Srini0047/ASIC-Implementation-of-Systolic-Array-based-DNN-accelerator/docs/presentation/img/lrb_fill_replay.png

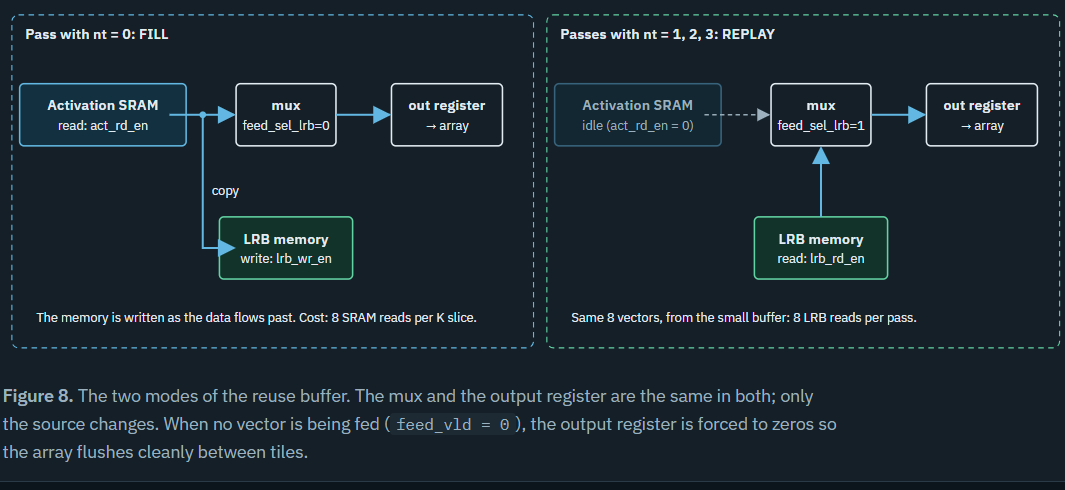
docs/presentation/img/lrb_fill_replay.png
