Srini0047/ASIC-Implementation-of-Systolic-Array-based-DNN-accelerator/docs/presentation/img/syn_top_schematic.png

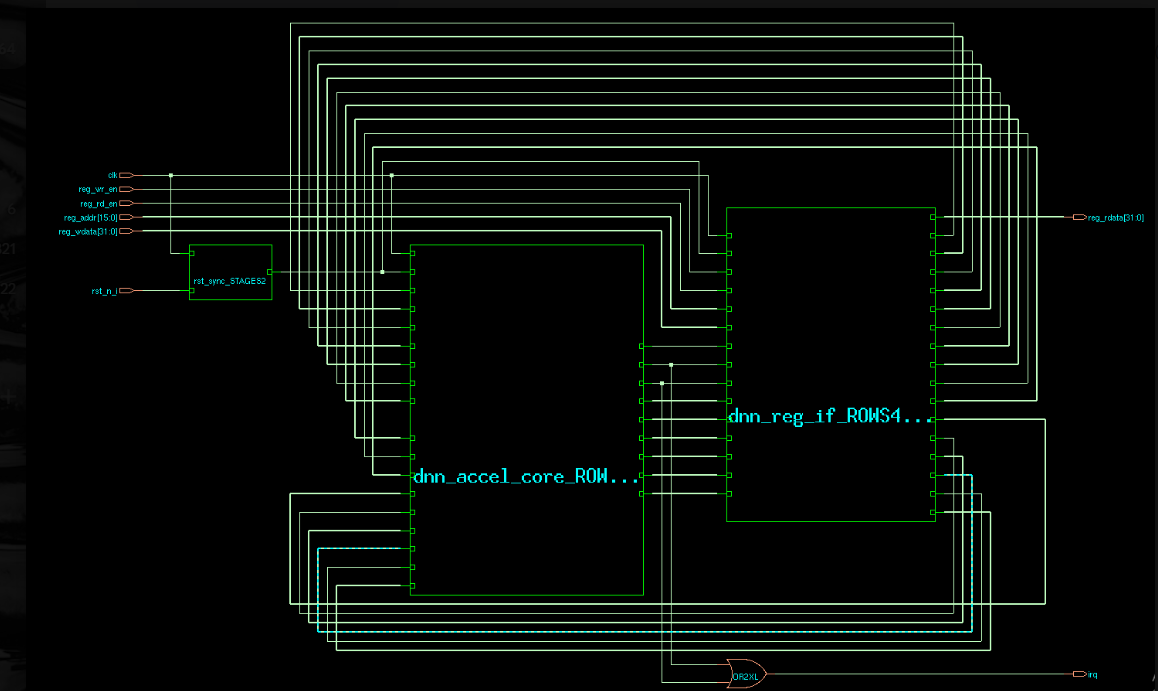
docs/presentation/img/syn_top_schematic.png
