Srini0047/ASIC-Implementation-of-Systolic-Array-based-DNN-accelerator/build/digits_preview.html

# The pictures in this project

Each picture is 8 x 8 = 64 pixels. Black = ink (value 1.0), white = paper (0.0). The number under each is the correct answer (the label).

## 1. The 360 test pictures, one batch of 8 per row

Row "batch k" is what the testbench feeds to the chip in batch k. The chip has never seen these during training.

batch 0

#0: 7

#1: 6

#2: 3

#3: 7

#4: 7

#5: 3

#6: 2

#7: 8

batch 1

#8: 9

#9: 3

#10: 2

#11: 6

#12: 6

#13: 4

#14: 5

#15: 8

batch 2

#16: 1

#17: 3

#18: 5

#19: 6

#20: 3

#21: 8

#22: 7

#23: 3

batch 3

#24: 0

#25: 2

#26: 8

#27: 4

#28: 5

#29: 8

#30: 6

#31: 7

batch 4

#32: 0

#33: 1

#34: 2

#35: 2

#36: 2

#37: 7

#38: 0

#39: 5

batch 5

#40: 9

#41: 9

#42: 0

#43: 9

#44: 1

#45: 1

#46: 3

#47: 5

batch 6

#48: 9

#49: 7

#50: 8

#51: 3

#52: 4

#53: 3

#54: 0

#55: 3

batch 7

#56: 4

#57: 2

#58: 6

#59: 0

#60: 4

#61: 8

#62: 9

#63: 1

batch 8

#64: 9

#65: 6

#66: 7

#67: 3

#68: 4

#69: 9

#70: 0

#71: 6

batch 9

#72: 2

#73: 8

#74: 8

#75: 3

#76: 8

#77: 9

#78: 7

#79: 9

batch 10

#80: 2

#81: 6

#82: 3

#83: 4

#84: 0

#85: 8

#86: 7

#87: 3

batch 11

#88: 5

#89: 0

#90: 1

#91: 4

#92: 9

#93: 6

#94: 3

#95: 4

batch 12

#96: 5

#97: 9

#98: 2

#99: 6

#100: 5

#101: 2

#102: 1

#103: 5

batch 13

#104: 9

#105: 1

#106: 1

#107: 1

#108: 9

#109: 7

#110: 6

#111: 9

batch 14

#112: 5

#113: 5

#114: 0

#115: 5

#116: 2

#117: 4

#118: 0

#119: 2

batch 15

#120: 7

#121: 2

#122: 8

#123: 1

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

INT8 in the chip

0 | 0 | 16 | 103 | 127 | 71 | 0 | 0
0 | 0 | 95 | 95 | 56 | 127 | 24 | 0
0 | 8 | 111 | 24 | 0 | 127 | 32 | 0
0 | 0 | 0 | 32 | 79 | 127 | 48 | 0
0 | 0 | 0 | 103 | 127 | 127 | 71 | 0
0 | 0 | 0 | 40 | 103 | 8 | 0 | 0
0 | 0 | 0 | 87 | 71 | 0 | 0 | 0
0 | 0 | 8 | 127 | 32 | 0 | 0 | 0
