Srini0047/ASIC-Implementation-of-Systolic-Array-based-DNN-accelerator/docs/BEGINNER_GUIDE.html

# Accelerator Beginner Guide

What the project files are, why each one exists, and exactly what to type. Written for someone who can simulate Verilog in Xcelium but has never seen the Python, C or script parts.

Everything in this guide was checked on the real files, with one limit: I do not have Xcelium, ModelSim, Genus or Innovus here. The simulation was tested on another 4-state simulator (Icarus) with identical results; the commands for your tools are written carefully but were not run on them. Section 11 says what to do if one fails.

## 0. Start here: your job list

The project is one chip design (Verilog) plus a small amount of helper material around it. You do not need to understand or run all of it. Your work is a setup step (Job 0) followed by five jobs, in this order. Job 1 needs only the simulator you already have.

Job 1: run the simulationXcelium or ModelSim runs the chip on 360 handwritten-digit images and prints PASSED.

about 20 minutes · section 6

Job 2: look at the waveformOpen the signals, take 3–4 screenshots for your report.

about 30 minutes · section 7

Job 3: the Python sideRebuild the chip's input, print the accuracy report. Optional, but it is what makes this a neural-network project.

about 30 minutes · section 8

Job 4: synthesisGenus turns the design into gates and reports area, speed and power.

1–3 hours, depends on your lab setup · section 9

Job 5: the reportFill in the numbers table and write it up.

section 10

You do this

If you only have one hour: do Job 1. It proves the design works and it needs no Python at all, because the input file the chip reads (build/prog.hex) is already inside the zip.

You can ignore

Verilator (I used it, you do not need it), the C driver (explained in section 3, you never run it), PyTorch training (already done, result is shipped), and every file ending in .sh in the scripts folder (they call Verilator; your replacements are in the cadence folder).

## 1. The story in plain words

The chip recognises handwritten digits. You give it a tiny 8×8 grey picture (64 numbers), it does a fixed amount of arithmetic, and it answers with ten scores, one per digit 0–9. The biggest score is its guess.

Analogy. Think of the chip as a vending machine that has ten judges inside. Each judge looks at the 64 pixels and gives a score for "how much does this look like my digit". The judges' preferences are a big table of numbers called weights. Somebody has to teach the judges (training), write their preferences down in whole numbers the machine can handle (quantization), and press the machine's keypad once for every number (loading). The machine itself never does any of that: it only does the arithmetic.

That "somebody" is the reason there is a Python folder, a C folder and a build folder. Figure 1 shows the whole chain. Blue boxes are Python on your PC. Green boxes are Verilog running inside the simulator.

Figure 1. Python prepares a text file of keypad presses; the testbench plays the role of the CPU and presses them into the chip; the chip's answers are written to a file that report.py turns into an accuracy number.

The file prog.hex is the link between the two halves. It is plain text, 9 677 lines: 9 676 keypad presses, one per line, plus a final END marker. Here is the beginning of it, decoded:

Line in prog.hex | Split into | Meaning
03000004d44a0100 | 03 · 00 · 0004 · d44a0100 | Operation 03 = "read and check". Read register number 4 (the chip's ID) and complain unless it equals d44a0100. It proves the testbench is talking to the right chip.
01001000fbfd0400 | 01 · 00 · 1000 · fbfd0400 | Operation 01 = "write". Put the value fbfd0400 at address 1000, which is the start of the weight memory. That value packs four weights (0, 4, −3, −5) into 32 bits.

The remaining lines load all 304 rows of weights, the biases, a description of each layer, then the pictures, then press START, wait, and read the answers back. The chip's own registers and memories are all reached the same way: an address and a number.

## 2. Basics from zero

### 2.1 What "the neural network" is here

It is two layers of multiplication and addition. Nothing else. For one picture:

Step | What happens | Shape of the numbers
Input | the 8×8 picture, flattened into one row of 64 numbers | x : [1 × 64]
Layer 1 | 16 "neurons". Each one multiplies all 64 pixels by its own 64 weights and adds them up, then adds a bias number. Negative results become 0 (this is called ReLU). | x [1×64] · W1 [64×16] + b1 [16] → h [1×16]
Layer 2 | 10 neurons, one per digit, each looking at the 16 numbers from layer 1 | h [1×16] · W2 [16×10] + b2 [10] → scores [1×10]
Answer | the position of the biggest score | argmax → one digit

A real example from this project (picture number 0, which is a handwritten 7): neuron 5 of layer 1 multiplies 64 pixel values by 64 weights and adds them up to 29 657, adds its bias 4 550 to get 34 207, and rescales that to 45. Layer 2 then gives the ten scores [−8, −14, −24, −10, −3, −27, −34, 34, −4, 20]. The biggest is 34 at position 7. The chip says "7". You can see every such number yourself with python sw\trace_one.py 0 5 (section 8).

The weights are the only thing that was "learned". Training (with a library called PyTorch) tried thousands of values until the guesses on known pictures were right. That already happened; the result is in build/model.onnx.

### 2.2 What "MAC" means, and why it is the whole game

A MAC is one multiply followed by one add: total = total + weight × pixel. Layer 1 needs 64 × 16 = 1 024 of them, layer 2 needs 16 × 10 = 160, so 1 184 MACs per picture. A neural-network chip is a machine for doing MACs cheaply. Doing them is easy; the expensive part is fetching the weights and pixels from memory, so the design is built to fetch each number as few times as possible.

### 2.3 What "systolic array" means

Analogy. A bucket brigade. Instead of every worker walking to the warehouse, each worker hands the item to the next person in the line. Here the "workers" are 16 small multiply-add circuits (PEs, processing elements) in a 4×4 grid. Each PE keeps one weight for a while, pixels flow across the grid from the left, and running totals flow down. Nobody talks to the big memory except at the edges.

Figure 2. The 4×4 array in rtl/pe.v and rtl/systolic_array.v. Four pixels enter on the left, staggered by one clock per row; each box multiplies its stored weight by the pixel passing through and adds it to the total arriving from above. Four sums leave at the bottom, which is 4 neurons answered at once.

A 4×4 array only sees 4 pixels and 4 neurons at a time, but the network has 64 pixels and 16 neurons. So the controller (rtl/dnn_ctrl.v) cuts the work into tiles: layer 1 becomes 16 × 4 = 64 tile-runs ("passes"), layer 2 another 12. In each pass it loads 4×4 = 16 weights (4 clocks), streams the 8 pictures of a batch through (8 clocks), and waits for the pipeline to empty (about 11 clocks). Partial totals from different tiles are added in a small memory. Everything in this paragraph is done by RTL you already have; you only need to know why the waveform looks the way it does.

### 2.4 Why 8-bit integers ("INT8")

Trained weights are decimals such as 0.0168. Decimal (floating-point) maths costs roughly ten times or more energy than 8-bit integer maths, so before the chip sees them each number is converted: pick a scale (0.01685 for layer 1), divide, round to a whole number between −127 and 127. This step is quantization and lives in sw/quantize.py. The price is a tiny accuracy loss; here there is none: the decimal network scores 96.94 % on 360 unseen pictures, and so does the integer network, and so does the chip.

The chip's integer sums are large (like 34 207), so the last stage shrinks them back to 8 bits with a "multiply by 44203, then shift right by 25 bits" step. That equals multiplying by 0.001317 without needing a decimal multiplier.

### 2.5 Why the chip cannot run by itself

The chip has memories that start empty and registers that start at zero. To use it, something must (1) write 304 rows of weights into the weight memory, (2) write the biases and a "work order" for each layer, (3) write the picture into the input memory, (4) write 1 to the START register, (5) wait until DONE, (6) read the answers back. In a real product a small CPU does this by running driver software. In your simulation the testbench does it by replaying prog.hex. Same steps, different actor. Section 3 shows this side by side (Figure 3).

## 3. What every folder is for

Open the unzipped folder systolic_dnn_accel. Inside are these folders. The coloured tag says what you need to do with each one.

- systolic_dnn_accel/
  - rtl/ your chipThe Verilog design: 17 files, of which 15 make up the DNN accelerator (the other two belong to the older matrix-multiply version). This is the actual accelerator.
  - tb/ use one filetb_dnn_player.v is the testbench. The other three are for the older first version.
  - cadence/ your launch filesNew. Ready-made commands for Xcelium, ModelSim, Genus, plus double-click Python helpers for Windows.
  - build/ inputs and outputsNumbers going into the chip and answers coming out. Pre-filled, so you can simulate straight away.
  - sw/ optional"Software": Python programs that prepare the chip's input and check its output.
  - driver/ read onlyC code a real processor would run. You never run it.
  - scripts/ ignoreMy own test runners; they need Verilator, which you do not have.
  - docs/ readingThe technical documents from before, plus this guide.
  - README.md, requirements.txt ignoreShort notes for people with the full open-source toolchain.

### 3.1 rtl/ and tb/: what you already understand

RTL is the chip: registers and logic written in Verilog. The files you would use if you were building the chip are all in rtl/. The top-level module is dnn_accel_top (or dnn_accel_axil_top, the same chip with an AXI bus plug on the front). Files starting with accel_ctrl or systolic_accel_top belong to the first, simpler version and are not part of the DNN design.

A testbench is Verilog that is not the chip; it exists only to poke the chip in simulation. tb/tb_dnn_player.v is a "player": it reads a program file (prog.hex), and for each line writes or reads one chip register, exactly as a CPU would. It counts mismatches and prints PLAYER PASSED or PLAYER FAILED.

### 3.2 sw/: why there is Python at all

The chip only understands integers and register writes. Someone has to turn "a trained neural network" into those. That someone is a short series of Python programs, each doing one job, all readable in a text editor:

File | What it does, in plain words | Needs | Run it?
train_mlp.py | Teaches the network to recognise digits, using the 1 797 example pictures that ship inside a library called scikit-learn. Saves build/model.onnx (the learned numbers). | PyTorch, scikit-learn, onnx (a very large download) | already done
quantize.py | Converts the learned decimals into whole numbers the chip can use, and finds the "multiply then shift" numbers. Prints float accuracy and integer accuracy. | numpy, onnx, onnxruntime | Job 3
golden.py | The "answer key": does the same integer arithmetic as the chip, but in Python, so the chip's answers can be checked bit for bit. | numpy | used by others
compiler_lib.py, compile.py | The "compiler": cuts the network into 4×4 tiles, decides which memory address each number goes to, and writes build/prog.hex (the keypad presses). Also writes net_image.h for the C driver. | numpy | Job 3
dnn_cfg.py | One list of chip settings (array size 4, memory depths) that must match the Verilog parameters. | nothing | used by others
report.py | Reads the chip's answers from build/rtl_readback.txt, computes accuracy from the chip's numbers, prints speed figures. | numpy | Job 3
trace_one.py | Follows one picture through the network and prints every number. This is the best "what is happening" teaching tool. | numpy | Job 3
example_tiny_net.py, show_tiny.py | A 4-number example small enough to check with a pencil, and a decoder for the chip's answer. | numpy (show_tiny.py needs nothing but Python) | Job 3
gen_random_net.py | Makes random networks and deliberately illegal commands for stress tests. | numpy | ignore
sweep_arch.py | Tries array sizes 4, 8 and 16 with Verilator to compare speed. Its table is already copied into docs/02. | Verilator | ignore

### 3.3 build/: what that folder is

"Build" folders hold generated files: things produced by running a program, as opposed to things a person wrote. If you delete something in build/ you can produce it again; if you delete something in rtl/ it is gone. I left the finished results in it so that your first simulation needs no Python.

File | What it is | Made by
model.onnx | The trained network (weights as decimals). ONNX is a standard file format for networks, like PDF is for documents. | train_mlp.py
data.npz | The 360 test pictures and their true labels. | train_mlp.py
qnet.npz | The same network after conversion to integers. | quantize.py
prog.hex | The main chip input. 9 676 keypad presses plus an END line (9 677 lines): load weights, run 45 batches of 8 pictures, read back answers. | compile.py
prog_meta.json | A label for each "read" in prog.hex, so report.py knows which answer is which. | compile.py
wave_prog.hex | The first 568 lines of prog.hex plus an END line: one batch only, so waveform files stay small. | cut from prog.hex
tiny_prog.hex | Program for the 4-number pencil example. | example_tiny_net.py
net_image.h | The network written as C arrays, for the C driver. | compile.py
rtl_readback.txt | The main chip output: every value the chip returned, one per line. Written by the simulator, read by report.py. | simulation
c_trace.hex, c_prog.hex, py_trace_first.hex, c_rtl_readback.txt, axil_readback.txt, tiny_readback.txt | Leftovers from my own tests (driver check, AXI check). Ignore them. | my scripts

### 3.4 driver/: what a "driver" is, and why you never run it

A driver is the program on the processor that knows how to talk to a piece of hardware. Your keyboard, GPU and Wi-Fi card all have one. For this chip, the driver is about 250 lines of C: dnn_load_network() writes weights and layer descriptions, dnn_write_input() writes a picture, dnn_run() presses START and waits, dnn_read_output() reads the ten scores.

It exists for two reasons. First, a chip without software is unusable, so a complete project shows how software would use it. Second, it is an independent check: I made the C driver produce its own list of register writes and compared it with the Python compiler's list. They match on all 568 accesses of the first batch, which means the register map documented in docs/05 is really what the chip does, and not just what one program believes. That is the whole reason for it. The C code is not needed for your simulation, and you cannot run it on your PC in any useful way because there is no chip attached.

Figure 3. The chip is identical in both worlds. Only the actor changes. The Python compiler and the C driver are two independent ways of producing the same register writes, which is why the driver appears in this project at all.

### 3.5 scripts/: what a script is

A script is a text file containing commands you would otherwise type one by one. A .sh file is a script for a Linux shell; a .bat file is the Windows equivalent. Running a script just means "type all the commands in that file for me". Nothing magic.

The scripts in scripts/ are mine. They build the chip with Verilator (a free simulator), run it, and compare results. You do not have Verilator, so you use the equivalents in cadence/, which call Xcelium or ModelSim instead:

My script (needs Verilator) | What it does | Your replacement
scripts/run_all.sh | Runs the whole chain: Python steps, simulation, report, driver check, AXI check. | Job 1 + Job 3, done by hand in sections 6 and 8
scripts/run_tiny.sh | The 4-number example. | cadence\run_modelsim.bat tiny or --prog build/tiny_prog.hex
scripts/run_wave.sh | Simulation that also saves a waveform file. | run_xcelium.sh --wave / run_modelsim.bat gui
scripts/check_driver.sh | Compares the C driver's writes with the Python compiler's. | none needed
scripts/run_dnn_regress.sh, run_regress.sh, run_mutations.sh | Big test campaigns: 240 random networks, 19 deliberately broken copies of the design. | none needed; results are quoted in docs/06
scripts/check_rtl_quality.sh, check_psum_formula.sh | Lint and structure checks; a formula check. | none needed (Genus and Xcelium do their own checks)

Why this matters

If someone asks in your presentation "how do you know the design is correct", the honest answer is: the chip returns exactly the same numbers as an independent integer model, on 360 pictures and on 240 random networks, and 19 deliberately introduced bugs were all caught by those tests. These are the scripts that did it. You only need to reproduce the first part (Job 1).

## 4. Words you will meet

Word | Plain meaning
Terminal / command prompt / cmd | A window where you type a command and press Enter. On Windows it is called Command Prompt (cmd); on Linux it is the terminal.
Current folder ("working directory") | The folder the terminal is "standing in". Commands with a relative path like build/prog.hex look inside it. Almost every problem with these files comes from being in the wrong folder. You want to be in systolic_dnn_accel.
cd | "Change directory": walk the terminal into another folder. cd systolic_dnn_accel steps into it.
pip | Python's installer for add-on libraries. pip install numpy downloads numpy.
numpy, onnx, onnxruntime | Python libraries: number arrays, the network file format, and a program that runs a network from that format.
Hex file | A text file of numbers written in base 16 (0–9 then a–f). fb = 251 = a single byte.
Register | A numbered mailbox inside the chip. Writing a number to it changes chip behaviour; reading it tells you something.
Batch | Several pictures processed together (8 here) so that each weight loaded is used 8 times.
INT8 / bias / ReLU | Whole numbers from −128 to 127 / a fixed number added to each neuron's sum / "turn negative into 0".
Plusarg (+prog=...) | A setting typed after the simulator command, starting with +. It tells the testbench which program file to read.
Waveform | A picture of signals against time, like a heart monitor for the chip.
Synthesis, netlist | Turning Verilog into a list of real logic gates from a manufacturer's library. That list is the netlist.
SDC | A short file telling the synthesis tool the speed you want (the clock) and what surrounds the chip.
Slack | Spare time on the slowest path. Positive is good (fast enough); negative means the clock is too fast for the gates.

## 5. Job 0: set up your files

You have two possible setups. Find out which you have before continuing, because the commands differ.

| Setup A: everything on your Windows PC | Setup B: Cadence tools on a Linux server or lab machine
How you know | You can start ModelSim from the Windows Start menu, and Python works in the same cmd window. | You log in remotely (a terminal, or a remote desktop) to a Linux machine to use Xcelium, Genus, Innovus.
Simulator | ModelSim, using cadence\run_modelsim.bat | Xcelium, using bash cadence/run_xcelium.sh
Python | same PC, cmd | either on your PC (recommended), or the server's Python 3 if it has numpy
Genus / Innovus | not available here, go to the Linux machine for Job 4 | the same Linux machine

Setup B and Python: two kinds of file travel

In Setup B the simulator runs on the server but your Python (Job 3) is on your PC, so the files they produce must be moved by hand (WinSCP, step 5 below, works both ways):

- Made by Python on the PC, needed by the simulator: build/prog.hex and build/tiny_prog.hex. Only when you regenerate them; the shipped copies already work.
- Made by the simulator on the server, needed by Python: build/rtl_readback.txt (for the report) and build/custom_readback.txt (for the pencil example). Copy them into the same build folder on the PC.

The shortcut that avoids all copying: run the Python steps on the server as well, with python3 instead of python and forward slashes (Job 3 shows both forms). That needs numpy on the server: test it with python3 -c "import numpy"; no output means it is there.

Most university Cadence installs are Setup B. The instructions below cover both. If you are unsure, do steps 1 to 4 (they are needed in both), and ask your lab assistant how to open a terminal on the Cadence machine.

1. Put the zip somewhere with a short path.
  In File Explorer, find systolic_dnn_accel_v2.zip. Right-click it, choose Extract All…, and in the box that asks where, replace the suggested path with C:\projects (click Browse and create the folder if it does not exist), then click Extract. Avoid folders with spaces in their names such as "My Documents". You now have C:\projects\systolic_dnn_accel.
2. Open a command window standing in that folder.
  In File Explorer open C:\projects\systolic_dnn_accel. Click once in the address bar at the top (where the path is written), type cmd, press Enter. A black window opens whose first line ends with systolic_dnn_accel>. That is the "current folder" from section 4.
3. Check that you are in the right place.
  Type in: Windows cmdCopy

dir
  The listing must include rtl, tb, sw, build, cadence. If it does not, you are one folder too high or too low: use cd to move.
4. Check Python.
  Type in: Windows cmdCopy

python --version
  You should see Python 3.13.3. If Windows says "python is not recognized", try py --version; if that works, use py instead of python everywhere in this guide, and write py -m pip install ... wherever the guide says python -m pip install ....
5. Setup B only: copy the folder to the Linux machine and open a terminal there.
  Ask your lab how they move files (a shared network drive is common). If they have no preference, the free program WinSCP works: start it, in the login window choose File protocol: SFTP, type the server's Host name, your User name and password, click Login. The window shows your PC on the left and the server on the right. Drag the systolic_dnn_accel_v2.zip file from left to right. Then in the server's terminal:
  Type in: Linux terminalCopy

unzip systolic_dnn_accel_v2.zip
cd systolic_dnn_accel
ls
  If unzip is not installed, use python3 -m zipfile -e systolic_dnn_accel_v2.zip . instead. ls should list the same folders as above.
6. Setup B only: make the Cadence tools available.
  Cadence tools are usually not on the search path until you run a lab-specific setup line, something like source /opt/cadence/setup.csh or module load xcelium. Ask your lab assistant for "the line that loads Xcelium and Genus". Then check:
  Type in: Linux terminalCopy

which xrun
which genus
  Each must print a path. If it prints "no xrun in …", the setup line has not been run in this terminal window. (Each new terminal window needs it again unless your lab put it in your login file.)

## 6. Job 1: run the simulation

Goal: make the simulator run all 360 test pictures through your chip and print PASSED. What happens inside: the testbench reads build/prog.hex line by line, pushes each line into the chip as a register write or read, and compares every answer with the expected one that is already stored inside the file.

You do this

Make sure your terminal is standing in the systolic_dnn_accel folder (section 5, steps 2 and 3). Then follow Setup A or Setup B, not both.

### Setup A: ModelSim on Windows

1. Type the launch command.
  Type in: Windows cmd, inside systolic_dnn_accelCopy

cadence\run_modelsim.bat
  Or, in File Explorer, open the cadence folder and double-click run_modelsim.bat. It does the same and keeps its window open at the end. If Windows shows a blue "protected your PC" box, click More info, then Run anyway.
2. Wait. ModelSim first compiles the 16 Verilog files (the testbench plus the 15 design files; a few seconds), then simulates about 0.9 milliseconds of chip time. This takes from under a minute to a few minutes depending on the ModelSim edition.
3. Find the result near the bottom of the window.

If the .bat file does not work for any reason, this single command does the same thing (it needs vsim to be found too; if cmd says "vsim is not recognized", read the first row of the table in section 11):

Type in: Windows cmd, inside systolic_dnn_accelCopy

vsim -c -do cadence/run_modelsim.do

### Setup B: Xcelium on Linux

1. Type the launch command.
  Type in: Linux terminal, inside systolic_dnn_accelCopy

bash cadence/run_xcelium.sh
  (Use bash even if your terminal uses another shell; the file is written for bash.) The script checks that xrun exists, then runs it with the right file list and settings. It creates a few temporary files (xcelium.d, xrun.log) that you can delete later.
2. Wait a few minutes at most.
3. The last line of the output tells you the result.

### What a good result looks like

The simulator prints many of its own lines. Look for these two, which come from the testbench, and for the last line of the Xcelium script:

PLAYER: 9677 ops, 1313 reads, 0 mismatches, 0 timeouts, 79785 cycles polling
*** PLAYER PASSED ***
(Xcelium script only, last line:)
>>> RESULT: PASSED  (readback written to build/rtl_readback.txt)

What each number means:

Item | Meaning
9677 ops | The testbench executed all 9 677 lines of prog.hex (the last one is the END marker).
1313 reads | It read 1 313 values back from the chip. Of these, 1 088 were checked against the expected answer stored in the file: 8 ID/configuration registers plus 1 080 answer words (45 batches × 8 pictures × 3 words per picture). The other 225 are speed counters that are only logged.
0 mismatches | Every one of the 1 088 checks matched. This is the number that proves the chip is correct.
0 timeouts | The chip never got stuck waiting for itself.
79785 cycles polling | How long the testbench waited for the chip to finish, in clock cycles. It should be the same on your simulator; if it differs by a few cycles that is not a problem.

Harmless warnings

You will probably see a warning that $readmemh found fewer words than the memory it is filling (the memory has room for 262 144 lines and the file has 9 677). Some simulators also print a warning about missing timescales, or about unused parameters. If the two lines above appear, ignore the warnings.

If you see FAILED

Copy the first ten lines that contain FAIL or MISMATCH, plus the tool name and version, and send them to me. Section 11 lists the usual causes first.

### Optional second run: through the AXI bus

The same test, but the testbench talks to the chip through an AXI4-Lite bus plug (the standard way a processor connects to a peripheral), with random delays. It should also pass.

Type in: Windows cmd (Setup A)Copy

cadence\run_modelsim.bat axi

Type in: Linux terminal (Setup B)Copy

bash cadence/run_xcelium.sh --axi

Its answers go to build/axil_readback.txt, so the normal build/rtl_readback.txt from the first run stays untouched.

### The pencil example: see the chip do arithmetic you can check by hand

Before trusting 360 pictures, watch the chip do one tiny job. It takes two vectors of four numbers, multiplies them by a 4×4 weight table W = [1..16], adds a bias, and applies ReLU:

Step | Picture 0 | Picture 1
Input x [1×4] | [1 2 3 4] | [1 0 0 0]
x · W [1×4] 1·[1 2 3 4] + 2·[5 6 7 8] + 3·[9 10 11 12] + 4·[13 14 15 16] | [90 100 110 120] | [1 2 3 4]
+ bias [0 0 0 −200] | [90 100 110 −80] | [1 2 3 −196]
ReLU (negative becomes 0) | [90 100 110 0] | [1 2 3 0]

1. Run the chip on it.
  Type in: Windows cmd (Setup A)Copy

cadence\run_modelsim.bat tiny
  Type in: Linux terminal (Setup B)Copy

bash cadence/run_xcelium.sh --prog build/tiny_prog.hex
2. Print what the chip answered. show_tiny.py needs nothing but Python itself. The simulator left its answers in build/custom_readback.txt on the machine where it ran, so run the decoder on that same machine.
  Type in: Windows cmd (Setup A), inside systolic_dnn_accelCopy

python sw\show_tiny.py
  Type in: Linux terminal (Setup B), inside systolic_dnn_accelCopy

python3 sw/show_tiny.py

image 0: chip returned word 0x006e645a -> numbers [90, 100, 110, 0]
image 1: chip returned word 0x00030201 -> numbers [1, 2, 3, 0]
  The numbers are the ones you computed by hand. That is the chip's arithmetic, including the bias and ReLU.

## 7. Job 2: look at the waveform

A waveform shows every chosen signal as a line against time. You will use it to see the chip's state machine working through the network, and to take screenshots for your report. The waveform uses only the first batch (8 pictures; about 2 400 clock cycles in all, of which the chip itself is busy for 1 771), so it opens quickly.

### Setup A: ModelSim

1. Launch.
  Type in: Windows cmd, inside systolic_dnn_accelCopy

cadence\run_modelsim.bat gui
  The ModelSim window opens, compiles, simulates and fills the Wave window with the interesting signals already grouped under headings. If a box ever asks "Are you sure you want to finish?", click No: Yes closes ModelSim and your waveform with it.
2. If the Wave window looks empty or cramped, click on it once, then press f (zoom full). To zoom into a region, hold Ctrl and use the mouse wheel, or drag with the middle mouse button.
3. Click anywhere in the waveform to place a cursor. The value of every signal at that time appears in the left column.

### Setup B: Xcelium (SimVision)

1. Launch.
  Type in: Linux terminal, inside systolic_dnn_accelCopy

bash cadence/run_xcelium.sh --gui
  SimVision opens with a Design Browser window (a hierarchy tree on the left, signal list on the right) and a Console window with a command prompt. The simulation is loaded but paused at time 0.
2. In the Design Browser, expand the tree on the left by clicking the small triangle or plus sign next to: tb_dnn_player → g_reg → dut → u_core → u_ctrl. The right side now lists the controller's signals.
3. Click state. Hold Ctrl and click layer_cnt, kt_cnt, nt_cnt, m_cnt, busy, done, err. Then click the toolbar button that sends selected signals to a waveform (its tooltip says "Send to Waveform Window"; it is also in the right-click menu). A Waveform window appears.
4. Go back to the tree and repeat step 3 for these places:
  - tb_dnn_player: signals clk, reg_wr_en, reg_addr, reg_wdata
  - tb_dnn_player → g_reg → dut → u_core: signals acc_wr_en, acc_rd_en
  - … u_core → u_core (the array itself): signal res_vld
5. In the Console window, type run and press Enter. The simulation runs to its end in a few seconds.
6. In the Waveform window use the zoom-to-fit button (hover over the toolbar icons to read their names) or the menu View → Zoom → Fit.

Menu names

I could not open SimVision here, so button and menu names come from how the tool is normally laid out. If one is missing, hover over the toolbar icons or look in the right-click menu; the actions (send signals to waveform, run, zoom to fit) exist in every version. As a fallback, run bash cadence/run_xcelium.sh --wave: it writes build/dnn.vcd, a standard waveform file that SimVision (simvision build/dnn.vcd) and free viewers such as GTKWave can open.

### What you are looking at

Figure 4. What the waveform shows, drawn as a schematic. Phase 1: the testbench writes weights, biases and the picture; the chip is idle (state 0). Phase 2: START; the controller then repeats FETCH once per layer and LDW → COMP → DRAIN for every tile. The numbers are the values you will see in the state row; the cycle counts are the measured ones.

Signal | What it tells you
state | 0 IDLE, 1 FETCH, 2 LDW (load weights), 3 COMP (compute), 4 DRAIN (wait for results and store them)
layer_cnt | 0 while doing layer 1 (64 inputs → 16 neurons), then 1 for layer 2 (16 → 10)
kt_cnt, nt_cnt | Which 4×4 tile is being processed. nt_cnt cycles 0–3 quickly inside each kt_cnt value; kt_cnt goes 0 to 15 in layer 1. 16 × 4 = 64 passes.
m_cnt | Which of the 8 pictures is being fed (0–7) during COMP
res_vld | High while finished sets of 4 sums come out of the array: one solid block of 8 clocks per pass (one set per picture, back to back)
acc_wr_en / acc_rd_en | The partial-sum memory being written (all tiles except the last) and read (all tiles except the first). This is the "add the tiles together" traffic.
busy, done, err | busy is high from START to the end; done goes high when the last layer finishes; err would go high if the chip rejected a layer description

Screenshots to take for the report

1. The loading phase: reg_wr_en, reg_addr, reg_wdata, busy, state = 0. Caption: "the CPU stand-in loads weights and pictures".
2. Zoomed on 2–3 passes: state cycling 2 → 3 → 4, with kt_cnt, nt_cnt, res_vld. Caption: "one tile pass = load 4 clocks, compute 8, drain about 11".
3. A zoom on acc_wr_en and acc_rd_en across a change of kt_cnt. Caption: "partial sums accumulate across K-tiles".
4. The end: layer_cnt changing from 0 to 1, and finally done rising.

## 8. Job 3: the Python side

You can skip this job and still have a passing simulation. It is what shows that the chip runs a neural network and not just a multiplier, and the accuracy figure in your report comes from it. It uses only Python and the folder you already have. None of it touches the Cadence tools.

### 8.1 Install the three libraries (once)

Type in: Windows cmd, inside systolic_dnn_accelCopy

python -m pip install numpy onnx onnxruntime

It downloads a few tens of megabytes and ends with a line beginning Successfully installed. You do not need PyTorch (a multi-gigabyte download) because the training result is already shipped.

If pip complains

Python 3.13 is new. If pip reports "no matching distribution" for onnxruntime, first run python -m pip install --upgrade pip and retry. If it still fails, skip quantize.py: only numpy is needed for compile.py, report.py, trace_one.py and the pencil example, and the quantized network is already in build/qnet.npz. I tested these programs on Python 3.11, not 3.13.

### 8.2 Rebuild the chip's input

This redoes the middle of Figure 1: quantize, then compile. The result has exactly the same content as the prog.hex that was shipped (it is deterministic; on Windows the invisible line-ending characters may differ, which does not matter), so nothing changes, but you see how it is made.

Type in: Windows cmd, inside systolic_dnn_accelCopy

cadence\python_flow.bat

On Linux (Setup B, Python on the server) the same two steps are:

Type in: Linux terminal, inside systolic_dnn_accelCopy

python3 sw/quantize.py
python3 sw/compile.py

If you ran these on your PC but simulate on the server, copy the new build/prog.hex to the server's build folder before Job 1 (see the note in section 5).

Output, shortened, with what each line means:

layer 1: W(64, 16) relu=True s_w=0.01685 s_out=0.10071 mult=44203 shift=25 (real 0.001317 ~ 0.001317)
layer 2: W(16, 10) relu=False s_w=0.01257 s_out=0.21849 mult=48617 shift=23 (real 0.005796 ~ 0.005796)
float (onnxruntime) accuracy : 96.94%
INT8 integer-only accuracy   : 96.94%   (this is what the RTL must reproduce)
compiled 2 layers, 45 batches of 8: 9676 register ops (361 static), weight words 304/512
  layer 0: K 64->64 (KT=16)  N 16->16 (NT=4)  passes=64  src=0 dst=128  wbase=0
  layer 1: K 16->16 (KT=4)  N 10->12 (NT=3)  passes=12  src=128 dst=0  wbase=256

Line | Meaning
W(64, 16) | Layer 1's weight table has 64 rows (pixels) and 16 columns (neurons).
s_w=0.01685 | The scale used to turn this layer's decimal weights into whole numbers.
mult=44203 shift=25 | The "multiply then shift" pair that approximates the rescaling factor 0.001317 with integers.
float / INT8 accuracy | The decimal network and the whole-number network both get 96.94 % of the 360 test pictures right, so the conversion cost nothing.
9676 register ops | Keypad presses in prog.hex: 361 to set the chip up, then exactly 207 per batch of 8 pictures, times 45 batches.
weight words 304/512 | The weight memory has room for 512 rows of weights; the network uses 304.
K 64->64 (KT=16) | 64 inputs, which need 16 tiles of 4 to cover them (KT = number of K-tiles).
N 10->12 (NT=3) | 10 outputs, rounded up to 12 with zero weights so they fill 3 tiles of 4.
passes=64 | 16 × 4 = 64 times the array is loaded with a fresh weight tile for this layer.
src / dst / wbase | Memory addresses: where the layer reads its input, where it writes its output (the two swap roles for the next layer), where its weights start.

### 8.3 Get the report from the chip's answers

After Job 1 the simulator left build/rtl_readback.txt. On Setup B it is on the server: copy it into the build folder on your PC first (section 5 note), or run the Linux form below on the server. Turn it into numbers:

Type in: Windows cmd, inside systolic_dnn_accelCopy

cadence\python_report.bat

Type in: Linux terminal (Setup B, Python on the server), inside systolic_dnn_accelCopy

python3 sw/report.py

Shortened; the real output has a few extra lines.

images classified by the RTL     : 360
float model accuracy (PyTorch)   :  96.94 %
INT8 python golden accuracy      :  96.94 %
INT8 accuracy measured FROM RTL  :  96.94 %
per batch of 8 images (cycles from the RTL perf counters):
  busy cycles          :     1771   (221 cycles/image)
  useful MACs          :     9472   (5.35 MAC/cycle, peak 16)
  array utilization    :     33.4 %
  weight-SRAM reads    :      304 words
  act-SRAM reads       :      160 words
  LRB reads (reuse)    :      448 words
  activation fetches served by the LRB : 73.7 %  (act-SRAM reads cut 3.80x)
  bytes moved per useful MAC: weights 0.128 + activations 0.257 + partial sums 1.865 = 2.250
  at 100 MHz:    451722 images/s   (pre-synthesis estimate)
- The three accuracies are the headline. Three independent computations of the same network (decimal, integer in Python, and your Verilog chip) give the same 96.94 %. The last line is computed only from numbers the chip returned.
- 221 cycles per image, 5.35 MACs per cycle of a possible 16: the chip does about a third of its peak. The rest of the time it is loading weights and emptying its pipeline (section 7, Figure 4).
- The reads lines show memory traffic. The small "reuse buffer" answered 448 of 608 activation fetches, so the big memory was read 3.8 times less.
- Bytes per MAC 2.25 versus 2.0: at this small 4×4 size the design moves slightly more bytes per multiply than a design with no reuse, because partial sums shuttle in and out of memory. A 16×16 array gets 0.43. This is an honest finding to put in your report; docs/00 explains why.
- 451 722 images/s is arithmetic on the cycle count assuming a 100 MHz clock. It is not a measurement of any chip. Replace it with your real clock after Job 4.

### 8.4 Follow one picture through the network

Type in: Windows cmd, inside systolic_dnn_accelCopy

python sw\trace_one.py 0 5

(On Linux: python3 sw/trace_one.py 0 5.)

It prints picture number 0 (a 7) as an 8×8 grid, then the first five products neuron 5 computes (and how many more there are), the sum 29657, the bias, the rescale to 45, all 16 layer-1 outputs, and the final ten scores with the winning digit. Read it once slowly; it is the most useful five minutes in the project. Try python sw\trace_one.py 17 5 for another picture.

### 8.5 Experiment with the pencil example

1. Open sw\example_tiny_net.py in Notepad (right-click → Open with → Notepad). Find the line MULT, SHIFT, RELU = 1, 0, True. Change 0 to 1 and save. This tells the chip to halve every result.
2. Run python sw\example_tiny_net.py. It prints the answers it expects: [[45 50 55 0] [1 1 2 0]]. Then simulate again (section 6, pencil example, step 1) and run the decoder, python sw\show_tiny.py. The chip must return the same numbers. (90 halved is 45; 1 halved and rounded is 1.)
  Setup B, Python on your PC: the simulator only sees your change if the new build/tiny_prog.hex is on the server, and the decoder only sees the chip's new answer if build/custom_readback.txt is back on the PC. Simplest is to do this whole experiment on the server: python3 sw/example_tiny_net.py, then bash cadence/run_xcelium.sh --prog build/tiny_prog.hex, then python3 sw/show_tiny.py. If show_tiny.py prints the old numbers [90, 100, 110, 0], it is reading a stale file.
3. Change the numbers in X or W and predict the output before you run it. When prediction and chip agree, you have understood what the accelerator does.

Not needed

train_mlp.py retrains the network. It needs PyTorch and a different hardware size if you widen the network, which is a bigger project. Tell me if your guide wants a different network and I will prepare the files.

## 9. Job 4: synthesis in Genus

Jobs 1–3 proved the design works. Job 4 answers the next question a chip person asks: how big is it, how fast can it run, how much power does it use? Only a synthesis tool can tell you, and Genus is yours.

### 9.1 What synthesis is

Analogy. Your Verilog is an architect's drawing: "here is a room that adds two numbers". A builder cannot order a drawing; a builder orders parts from a catalogue. Synthesis is the step that turns the drawing into a parts list: "12 000 NAND gates of catalogue type NAND2X1, 32 000 flip-flops of type DFFQX1, joined by these wires". The catalogue belongs to a chip factory and is called a standard-cell library; its file is a .lib. For every cell it lists delay, area and power. Genus adds these up to give you the three numbers for the report.

Genus needs | What it is | Where it comes from
The design | rtl/*.v (13 files for the core) | already in the zip
The catalogue | .lib file(s): timing, area and power of each real cell | your lab: depends on the chip technology you use
The speed goal | cadence/constraints.sdc: "the clock is 10 ns, the bus pins arrive 4 ns late" | already in the zip, you only change one number

Honest limit

I never had Genus, so cadence/genus_synth.tcl is a template I wrote from the tool's documented commands. It has not been run. It is short and the commands are standard, but expect that one line may need a small fix. Section 11 lists the messages you are likely to see.

### 9.2 Ask your lab for four things (one message)

I cannot know your lab's technology folder. Send this message to your lab administrator, teaching assistant or guide, and paste the answers into the steps below:

Message to send (not a command)Copy

I want to synthesize a Verilog design with Genus. Please tell me:
1. The folder and the file name(s) of the standard-cell .lib file(s)
   for the technology we use (typical or slow corner is fine).
2. The command or setup script that makes "genus" and "xrun" work in my terminal.
3. Which LEF files and which Innovus template I should use later for place and route.
4. Whether a memory compiler is available, or whether flip-flop memories are acceptable.

### 9.3 Run it

Genus runs on the lab's Linux machine, so this is Setup B from section 5 (the project folder must be on that machine; WinSCP copies it over).

1. Open a terminal on the Linux machine and go to the project folder.
  Type in: Linux terminalCopy

cd ~/systolic_dnn_accel
ls cadence
  The second command must list genus_synth.tcl and constraints.sdc. If not, you are in the wrong folder.
2. Open the template in a text editor and fill in the two lines that contain <<<.
  Type in: Linux terminalCopy

gedit cadence/genus_synth.tcl &
  If gedit is not installed, use nano cadence/genus_synth.tcl (save with Ctrl+O, Enter, leave with Ctrl+X). Replace the text between the quotes with the answers from question 1. The lines must look like this afterwards (the folder and file names below are examples, yours differ):

set LIB_DIR    "/pdk/mytech/lib/"
set LIB_FILES  "typical.lib"
  Keep the quotation marks. If there are several .lib files, put them in the same quotes separated by a space.
3. Start Genus. The -f option means "run this script", -log saves everything it prints.
  Type in: Linux terminal, inside systolic_dnn_accelCopy

genus -f cadence/genus_synth.tcl -log genus.log
4. Wait. Genus prints a banner and many lines. The design holds about 32 000 bits of memory that the tool builds out of flip-flops (see 9.5), so this can take from a few minutes to about an hour. Do not press anything. When it finishes you see this line and the terminal returns:

DONE - open genus_out/timing.rpt, area.rpt, power.rpt
5. Check that nothing was silently wrong.
  Type in: Linux terminal, inside systolic_dnn_accelCopy

grep -i -E "error|unresolved" genus.log | head -20
ls genus_out
  The first command should print nothing serious (a few harmless warnings are normal). ls must list timing.rpt area.rpt power.rpt gates.rpt, the netlist dnn_accel_top_netlist.v and dnn_accel_top.sdc.

### 9.4 Read the three reports

Open each file with gedit genus_out/timing.rpt (or WinSCP it back to Windows and open it in Notepad).

File | What to look for | What to copy into your report
timing.rpt | The worst signal path, then a line containing slack (Genus prints it as "Timing slack"). Slack is spare time: how much earlier than the deadline the slowest signal arrives. Check the unit printed next to the number: Genus normally reports picoseconds (ps), and 1000 ps = 1 ns. | the slack value with its unit, and the clock period you used
area.rpt | A "Total area" line. The unit is set by the library (usually µm²); the header of the report or the library documentation says which. | total area and unit; cell count from gates.rpt
power.rpt | A total, usually split into leakage (power when idle), internal and switching (power when signals move). | total power and the split
gates.rpt | How many cells of each kind. Expect a very large number of flip-flops. | number of flip-flops versus logic cells

How to read slack

Slack ≥ 0: the design meets the 10 ns clock you asked for. Slack < 0: too slow. Either way the fastest clock the design can take is roughly period − slack, with both in the same unit (convert ps to ns first: 1 300 ps = 1.3 ns).

Example A (numbers invented): period 10 ns, slack +1.3 ns → about 8.7 ns → 1000 / 8.7 ≈ 115 MHz.
Example B: period 10 ns, slack −2.0 ns → about 12 ns → 1000 / 12 ≈ 83 MHz.

To find the real limit, change the clock period and rerun:

1. Open cadence/constraints.sdc and edit the line set clk_period 10.0. Put the value you computed (for example 12.5 after example B, so you have a little margin) and save.
2. Run the same genus -f ... command again. Slack should now be ≥ 0.
3. Report the smallest period that still gave slack ≥ 0 as your maximum clock, together with its area and power. Area and power change slightly with the period, so always quote all three numbers from the same run.

### 9.5 Two things to say honestly in your report

- The memories became flip-flops. The design's memories are written as plain Verilog arrays (rtl/sram_sdp.v), so Genus builds each stored bit from a flip-flop: 30 976 bits in the five memories plus 1 024 bits in the layer-description store. A real chip would use compiled SRAM macros, which are much smaller. Say so, and treat the area as an upper bound. (docs/06, section 3 explains how to swap them.)
- The power is a statistical guess. Without an activity file Genus assumes how often signals switch. A better number uses the simulation's own activity (docs/06 mentions read_vcd and report_power). For a first report, quote the estimate and label it an estimate.

### 9.6 Turning the numbers into speed and energy

The simulation gave you cycles (1 771 per batch of 8 pictures, 221.4 per picture). Synthesis gave you a clock frequency f and a power P. Multiply:

Quantity | Formula | Worked example (P = 10 mW is invented; f = 100 MHz)
Time per picture | 221.4 cycles ÷ f | 221.4 ÷ 100 MHz = 2.21 µs
Pictures per second | f ÷ 221.4 | ≈ 451 700 per second
Energy per picture | P × time per picture | 10 mW × 2.21 µs = 22.1 nJ

### 9.7 After Genus: Innovus (place and route)

Analogy. Genus wrote the parts list. Innovus is the town planner: it decides where every part sits on the silicon, draws the power lines, builds the clock distribution (so every flip-flop hears the clock at almost the same moment), and lays down the wires. The result is a layout, the file a foundry would manufacture from.

Figure 5. Where each tool sits. Genus needs a cell library and a constraints file and produces a gate netlist plus the three reports for your write-up. Innovus continues from the netlist but needs technology files that only your lab has.

Why there is no click-by-click Innovus section

Place and route cannot be started without the technology's LEF files, parasitic-extraction files and your lab's Innovus template. I do not have them, and typing guessed paths would only produce errors. Two ways forward: (1) ask your guide whether place and route is required for the project or whether Genus results are enough; (2) if it is required, send me the technology name, the LEF file paths and your lab's Innovus template, and I will write an innovus_pnr.tcl in the same style as the Genus one, with exact steps.

## 10. Job 5: numbers for your report

Everything in the first table was measured on the design; you can reproduce it with Job 1 and cadence\python_report.bat. The second table is what you fill in after Genus.

### 10.1 Numbers already measured (default 4×4 array, batch of 8 pictures)

Quantity | Value | Meaning
Network | 64 → 16 → 10 | two layers, 8×8 handwritten digits
Multiply-adds per picture | 1 184 | 64×16 + 16×10
Test pictures | 360 | 45 batches of 8
Accuracy: decimal / integer Python / RTL | 96.94 % each | the integer conversion and the chip lose nothing
Cycles per batch of 8 | 1 771 | 221.4 per picture
Passes per batch | 76 | times the array is filled with a new weight tile (64 + 12)
Where the cycles go | 2 / 304 / 608 / 857 | fetch / load weights / compute / drain (sums to 1 771)
Useful MACs per cycle | 5.35 of 16 | 9 472 useful multiply-adds ÷ 1 771 cycles
Array utilization | 33.4 % | 5.35 ÷ 16
Activation memory reads | 160 | plus 448 served by the reuse buffer: 3.8× fewer big-memory reads
Weight memory reads | 304 | each weight row read once per batch
Bytes moved per MAC | 2.250 | 0.128 weights + 0.257 activations + 1.865 partial sums (16×16 array: 0.43)
Tests passed | 1 088 compared reads, 0 mismatches | 8 ID/config words + 1 080 output words
Verification strength | 19 of 19 | deliberately broken copies of the design were all caught (docs/06)

### 10.2 Numbers you fill in after Job 4

Quantity | Your value | Where from
Technology / library name | ______ | your lab
Clock period used (ns) and slack (ns) | ______ | constraints.sdc, timing.rpt
Maximum clock = 1000 ÷ (period − slack) MHz | ______ | 9.4
Total area and unit | ______ | area.rpt
Number of flip-flops / logic cells | ______ | gates.rpt
Total power (mW) | ______ | power.rpt
Pictures per second = f ÷ 221.4 | ______ | 9.6
Energy per picture = P × 221.4 ÷ f | ______ | 9.6

### 10.3 A report outline that fits this project

1. Motivation: why neural-network inference needs dedicated hardware (many multiply-adds, mostly the same weights reused).
2. The network and INT8 quantization: 64→16→10, why whole numbers are enough (Figure 1 and section 2 of this guide; docs/01).
3. Architecture: weight-stationary 4×4 array, reuse buffer, post-processing unit (bias, rescale, ReLU), controller, register interface (docs/02, docs/05).
4. Verification: 360 pictures bit-exact against the Python answer key, random-network regression, the 19 deliberately broken designs (docs/06).
5. Results: tables 10.1 and 10.2, the waveform screenshots from Job 2, the cycle breakdown.
6. Discussion: 33.4 % utilization and why (each pass spends 4 cycles loading weights, 8 computing and about 11 draining the pipeline, so the array computes for roughly a third of the time); the 2.25 bytes per MAC finding; flip-flop memories; what a bigger array does (docs/04 roadmap).
7. Limits and future work: SRAM macros, place and route, larger networks.

If your guide asks: "why Python and C?"

The chip only multiplies and adds whole numbers, so something outside it must train the network, convert it to whole numbers and plan which memory address each number goes to; that is the Python part. In a real product a processor would press the chip's registers by running a program, and the C driver is that program; in this project the testbench plays the processor. The C driver is included, and tested to produce exactly the same register writes as the Python compiler, to show that the chip is usable by real software and that its register map is documented correctly.

## 11. If something fails

Nothing here is unusual for a first run on a new machine. Find the message, apply the fix. If it is not in the table, go to the end of this section.

What you see | Why | What to do
'vsim' is not recognized as an internal or external command (or xrun: command not found) | The tool exists but cmd or the shell does not know where. | Ask the lab for the setup command (question 2 in 9.2), or use the ModelSim shortcut in the Start menu that opens a prompt with the tool available. On Windows you can also type the full path in quotes, e.g. "C:\...\win64\vsim.exe" -c -do cadence/run_modelsim.do (the folder is called win32, win64 or win32aloem depending on your edition; look for vsim.exe).
'python' is not recognized, or a Microsoft Store window opens | Python is not on the PATH, or Windows uses its store stub. | Try py --version. If that works, use py in place of python everywhere (and edit the two .bat files in cadence the same way). Otherwise reinstall Python and tick Add python.exe to PATH.
ModuleNotFoundError: No module named 'numpy' | The add-on library is not installed. | python -m pip install numpy
pip says "no matching distribution" for onnx or onnxruntime | Python 3.13 is new; these libraries may not have a build yet. | python -m pip install --upgrade pip and retry. Otherwise skip quantize.py: the converted network is already in build\qnet.npz, so run python sw\compile.py alone.
pip cannot connect to the internet | Lab or campus proxy. | Ask the lab for the proxy setting. Job 3 is optional; Jobs 1, 2 and 4 do not need pip.
program file empty or not found followed by *** PLAYER FAILED *** at time 0 (often preceded by a $readmemh warning) | The tool was started in the wrong folder, so build/prog.hex was not found. | cd into the folder that contains rtl, tb and build, then run dir build\prog.hex (Windows) or ls build/prog.hex (Linux) to confirm.
The .bat window flashes and closes | You double-clicked a script that failed immediately. | Open cmd first (section 5), then type the script name so the message stays on screen.
Licence message such as "checkout failed" or "cannot connect to licence server" | The tool cannot reach the lab's licence server. | Work from the lab machine or the lab VPN, or ask the administrator. Nothing in the design causes this.
$'\r': command not found or bad interpreter when running a .sh file on Linux | The file picked up Windows line endings on its way over (an editor or a transfer program can do this). | Fix the file in place: sed -i 's/\r$//' cadence/run_xcelium.sh, then run it again. Do the same for any other file that shows this message.
Errors mentioning timescale | The testbench has a timescale and the design files have none; the order matters. | Use the provided scripts, which list the testbench first. If you write your own command, keep tb/tb_dnn_player.v before -f cadence/rtl_files.f.
Red lines / X at the very start of the waveform | Signals have no value before the reset is released. | Normal. Look after the reset ends; the summary line and 0 mismatches are what count.
The AXI run (--axi or axi) is rejected | Your tool version may treat the parameter override differently. | Skip it. The AXI wrapper is an extra; Job 1 without it is complete.
Genus: unresolved reference | A file is missing from the read_hdl list, or the working folder is wrong. | Start Genus from the project root; check that rtl/ holds the 13 files named in genus_synth.tcl.
Genus: a syntax error at $clog2 right after read_hdl | The -v2001 option is strict, and $clog2 is a Verilog-2005 function. | In cadence/genus_synth.tcl change read_hdl -v2001 { to read_hdl -sv { and run again. (I checked that the design also compiles in SystemVerilog mode.)
Genus: cannot find library / no cells | The two <<< lines are wrong. | Check the folder and file names against ls on the machine where Genus runs. The path must exist there.
Genus: "no ports matched" for reg_addr[*] and similar | The design was elaborated under a different top name. | The top must be dnn_accel_top (the DESIGN line of the template).
Timing slack is negative | The 10 ns goal is too aggressive for this library. | Not a failure. Raise clk_period as in 9.4.
*** PLAYER FAILED *** or mismatches above 0 | Something differs from the expected answers. | Follow the last paragraph below.

If it is not in the table

Send me: (1) the exact command you typed, (2) the last 30 lines the window printed, and for a mismatch the first ten lines containing FAIL, (3) the name and version of the tool (vsim -version or xrun -version). With those I can tell whether it is your setup or my script.

## 12. Every file, one line each

Root of the project: systolic_dnn_accel/. Files marked use are the ones you touch; ignore are safe to leave alone.

### Top level

README.md | The project's front page. Written for Linux and Verilator users; this guide replaces its "how to run" part for you.
requirements.txt | List of Python libraries for the full flow, including PyTorch. You only need numpy (and onnx, onnxruntime for quantize.py).

### cadence/ use

rtl_files.f | The list of the 15 design files, in the order the tools read them.
run_xcelium.sh | Job 1 and 2 on Xcelium (Linux). Options: --wave, --gui, --axi, --prog FILE.
run_modelsim.bat | Job 1 and 2 on ModelSim (Windows). Options: none, axi, tiny, gui, pe, pegui.
run_pe_xcelium.sh | Runs the single-PE testbench (tb/tb_pe.v) on Xcelium; --gui opens SimVision. Explained in RTL_EXPLAINED.html.
run_pe_modelsim.do, run_pe_modelsim_gui.do | The ModelSim command lists behind run_modelsim.bat pe and pegui.
run_modelsim.do, run_modelsim_axi.do, run_modelsim_gui.do, run_modelsim_tiny.do | The ModelSim command lists that the .bat calls: normal, AXI wrapper, waveform window, pencil example.
python_flow.bat, python_report.bat | Job 3 on Windows: rebuild the chip's input; print the accuracy and speed report.
genus_synth.tcl, constraints.sdc | Job 4: Genus script (fill in two lines) and timing goals (change one number).

### rtl/ the chip

pe.v | One processing element: multiplies a weight by an activation and adds to a running sum.
skew_delay.v | Delay lines that stagger the inputs so numbers meet the right weights at the right moment.
systolic_array.v | The 4×4 grid of processing elements.
sa_core.v | The grid plus the staggering logic and a "result valid" signal.
sram_sdp.v | A simple memory (one write and one read per cycle), used for weights, pictures, biases and sums.
lrb.v | Local reuse buffer: keeps recently used pictures close so the big memory is read less.
perf_counters.v | Counters for cycles, useful multiply-adds and memory reads (what report.py prints).
rst_sync.v | Turns the outside reset button into a clean internal reset.
dnn_ppu.v | After the sums: add bias, multiply-and-shift, clamp to 8 bits, ReLU.
dnn_ctrl.v | The sequencer: steps through layers, tiles and pictures (states FETCH, LDW, COMP, DRAIN).
dnn_accel_core.v | Wires the memories, array, reuse buffer, post-processing unit and controller together.
dnn_reg_if.v | The register file the outside world sees: ID, control, status, and windows into the memories.
dnn_accel_top.v | The top level for Genus and the normal simulation. Simple register bus.
axil_reg_bridge.v, dnn_accel_axil_top.v | Optional wrapper that speaks AXI4-Lite, the bus used inside real chips.
accel_ctrl.v, systolic_accel_top.v | ignore The older matrix-multiply-only version (v1). Not part of the DNN design.

### tb/

tb_dnn_player.v | use The testbench: replays prog.hex into the chip, checks the answers, writes rtl_readback.txt.
tb_pe.v, tb_systolic_accel.v, trace_2x2.v | ignore Testbenches of the older matrix-multiply version.

### sw/ (Python)

train_mlp.py | done Trains the network (needs PyTorch).
quantize.py | Job 3 Decimals to whole numbers.
compile.py, compiler_lib.py | Job 3 Whole numbers to prog.hex.
golden.py, dnn_cfg.py | The answer key and the shared hardware sizes. Used by the others.
report.py, trace_one.py | Job 3 The report; follow one picture.
example_tiny_net.py, show_tiny.py | Job 3 The pencil example and its decoder.
gen_random_net.py, sweep_arch.py | ignore Stress tests and array-size sweep (they need Verilator).

### driver/ (C)

dnn_accel.c, dnn_accel.h | The driver: load network, write picture, run, read result.
hal_mmio.h | How the driver would touch registers on a real system.
example_infer.c | A demo that uses a recording stand-in instead of hardware.

All four are ignore: you never compile or run them for the project.

### scripts/ (bash + Verilator, Linux only)

run_all.sh, run_dnn_regress.sh, run_regress.sh | My one-command flow and regressions.
run_mutations.sh, check_driver.sh, check_psum_formula.sh, check_rtl_quality.sh | My checks: broken-design test, driver comparison, formula check, lint.
run_tiny.sh, run_wave.sh | My versions of the pencil example and the waveform dump. Yours are in cadence.

All are ignore for you.

### build/ (generated)

prog.hex | use The chip's input program (9 677 lines).
wave_prog.hex | use First batch only, for small waveform files.
tiny_prog.hex | use The pencil example.
rtl_readback.txt | The chip's answers after Job 1; read by report.py.
prog_meta.json, prog_static.hex | Labels for the reads and the static part of the program.
model.onnx, model.pt, data.npz, qnet.npz, net_image.h | The trained network in several forms, the test pictures, the integer network, the C version.
c_prog.hex, c_trace.hex, c_rtl_readback.txt, py_trace_first.hex, axil_readback.txt, tiny_readback.txt | ignore Leftovers from my own tests.

### docs/ (Markdown, readable in Notepad)

BEGINNER_GUIDE.html | this guide Open it in any browser.
RTL_EXPLAINED.html | read What each of the 15 RTL files does, with diagrams and real waveforms, plus what both testbenches do and what their output should look like.
00_START_HERE.md | What is finished, how efficient it is, what to do next.
01_DNN_for_hardware_engineers.md | Neural-network theory in hardware terms, with the network's numbers.
02_project_mapping.md | How your original report's design maps onto this one.
03_software_stack.md | The Python flow in detail.
04_roadmap.md | Where the project can go next (good source for "future work").
05_register_map_and_driver.md | Every register address and the driver's functions.
06_verification_and_backend.md | What was tested and how; synthesis facts and checklist.
DESIGN_NOTES.md | Notes on the original matrix-multiply core (v1).
